OmarAlchikha/EMC-pre-compliance-rig/python/results/conducted_baseline.png

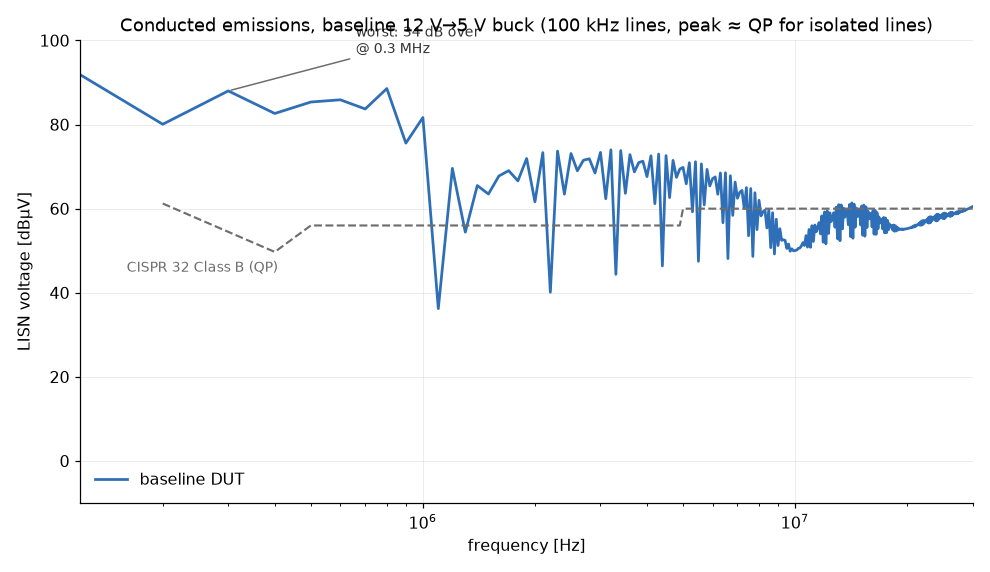
python/results/conducted_baseline.png
