OmarAlchikha/EMC-pre-compliance-rig/python/results/filter_middlebrook.png

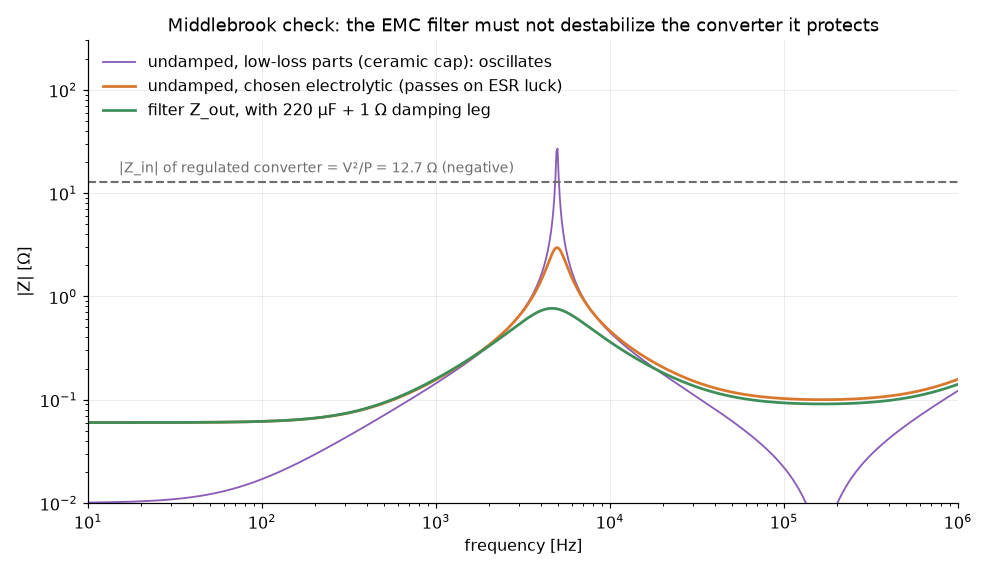
python/results/filter_middlebrook.png
