OmarAlchikha/EMC-pre-compliance-rig/python/results/probe_signal.png

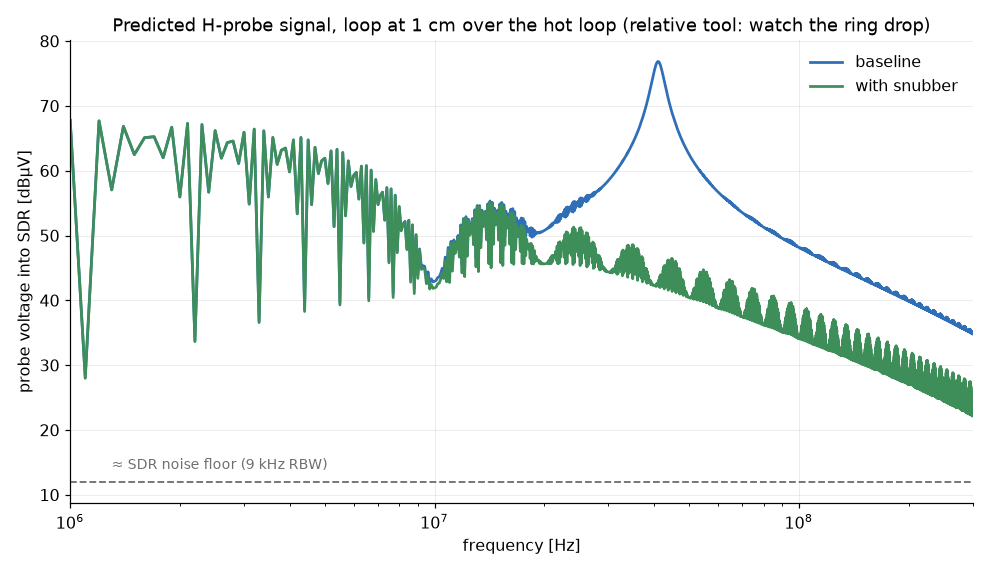
python/results/probe_signal.png
