OmarAlchikha/EMC-pre-compliance-rig/python/results/probe_transfer.png

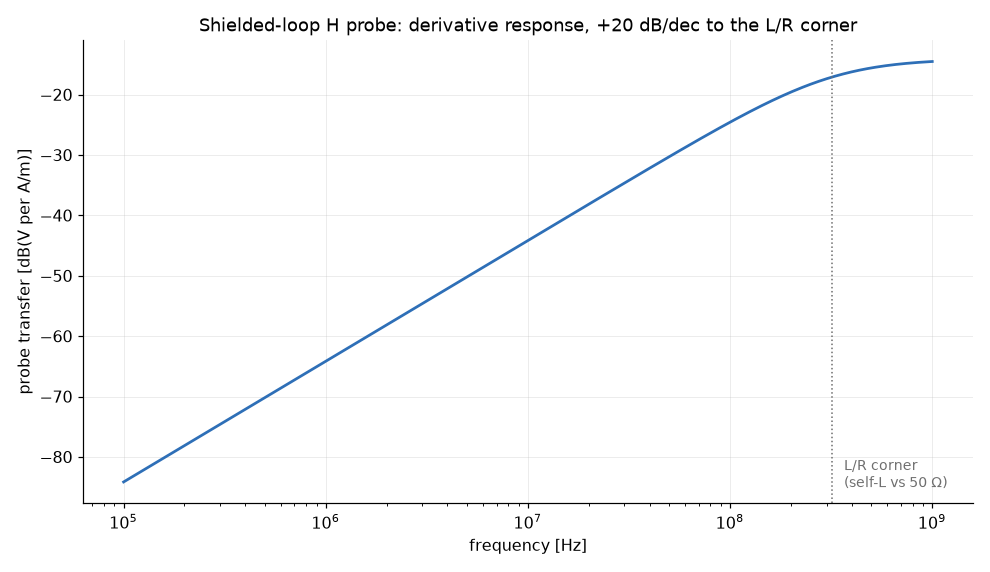
python/results/probe_transfer.png
