OmarAlchikha/EMC-pre-compliance-rig/python/results/radiated_baseline.png

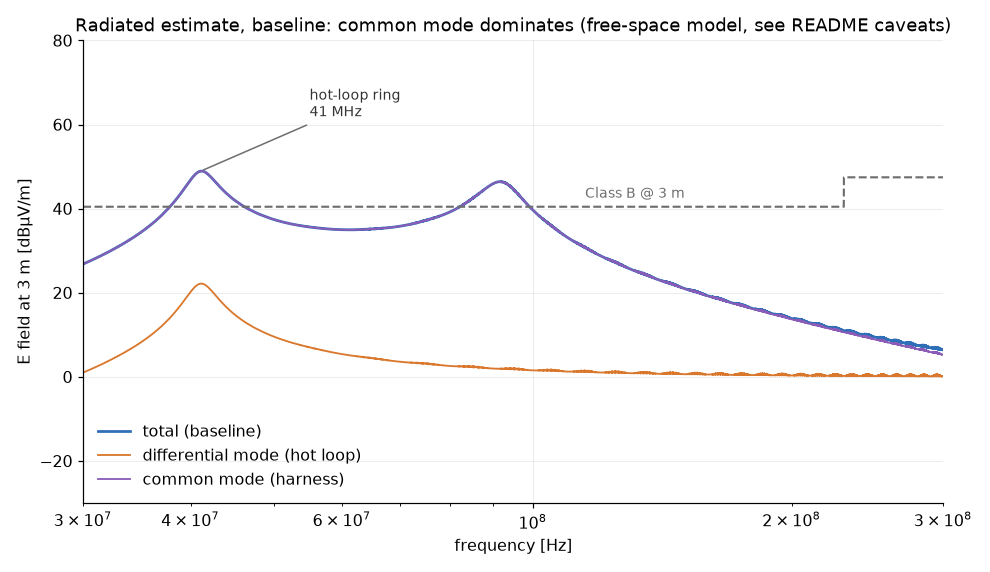
python/results/radiated_baseline.png
