OmarAlchikha/EMC-pre-compliance-rig/python/results/radiated_mitigated.png

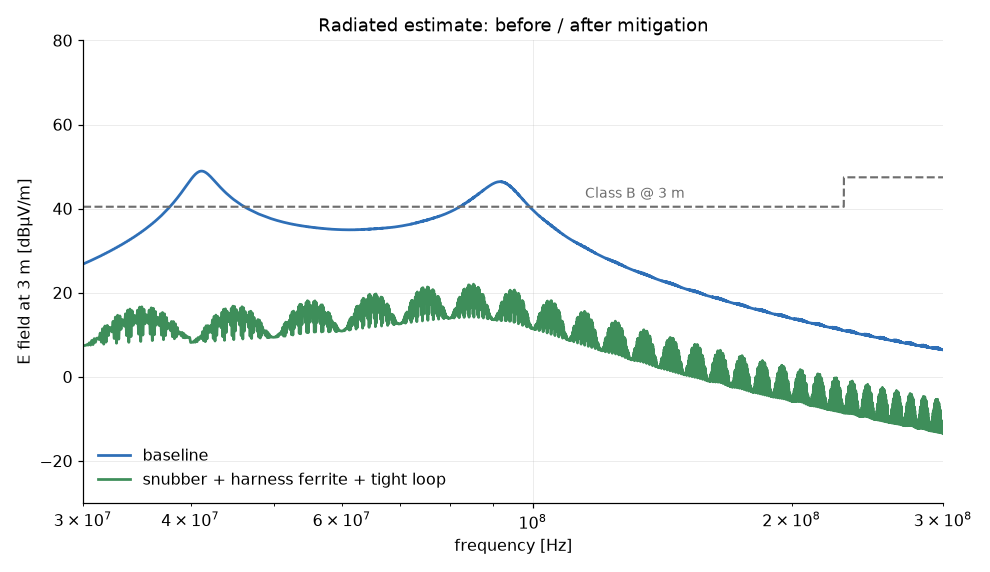
python/results/radiated_mitigated.png
