OmarAlchikha/EMC-pre-compliance-rig/python/results/sdr_synthetic_scan.png

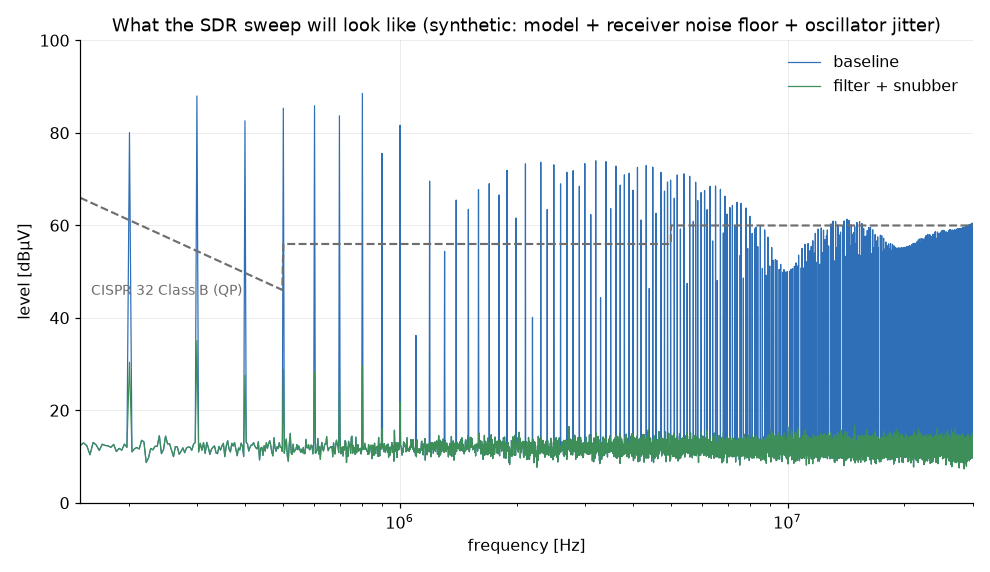
python/results/sdr_synthetic_scan.png
