OmarAlchikha/EMC-pre-compliance-rig/python/results/snubber_ring.png

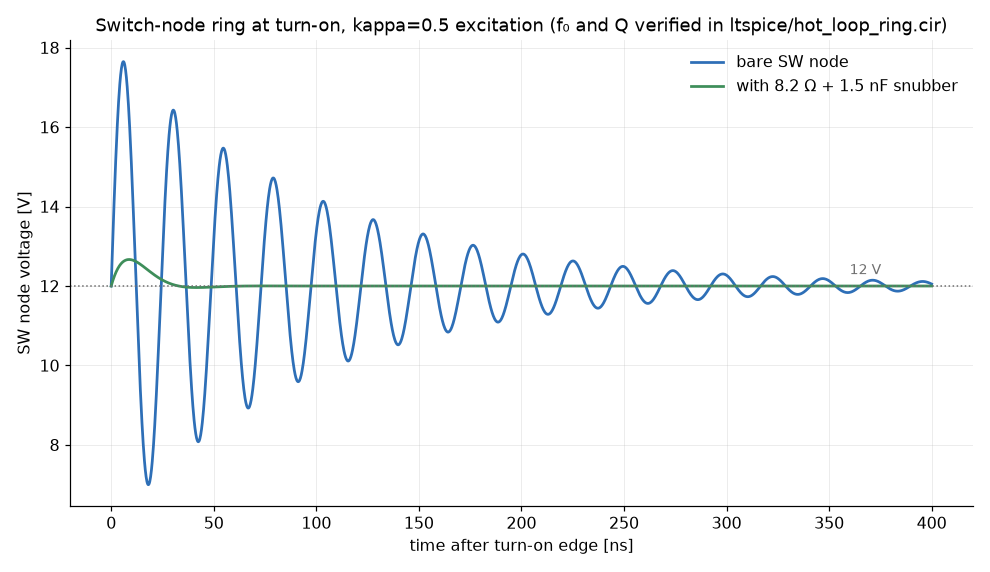
python/results/snubber_ring.png
